Open-Lab-Instruments/LCR/hardware/LCR.kicad_pcb

## KiCad design 0_kicad_project/project/project.kicad_sch

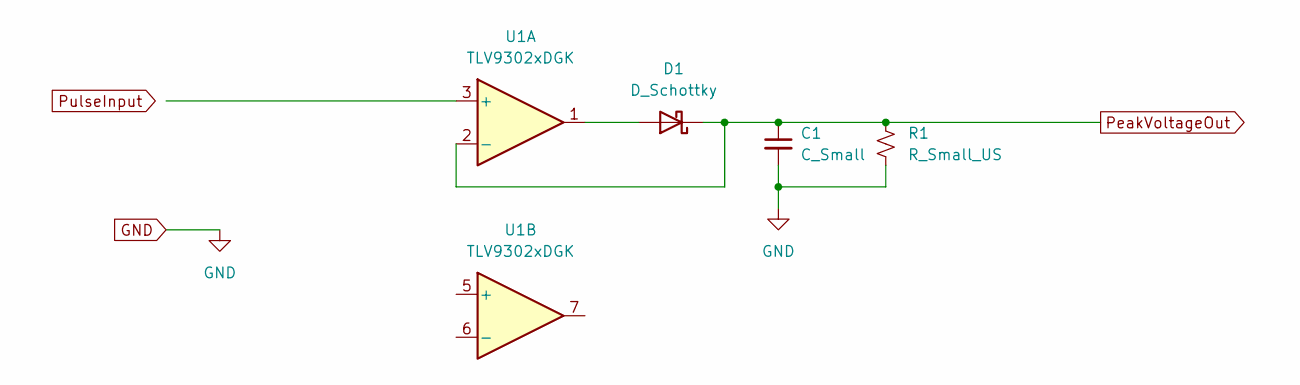
[picture p5: schematic project.kicad_sch]

Parts:
C1: C_Small
D1: D_Schottky
R1: R_Small_US
U1: TLV9302xDGK; MSOP-8_3x3mm_P0.65mm

Connections:
GND: C1.2, R1.2
unnamed: D1.2 (A), U1.1
PeakVoltageOut: C1.1, D1.1 (K), R1.1, U1.2 (-)
