Open-Lab-Instruments/LCR/software/LCRMeter/LCRMeter.ioc

Mcu.UserName=STM32F303VETx
PA0.GPIO_Label=TOUCH_IRQ
PA0.Signal=GPIO_Input
PA1.GPIO_Label=DISP_CS
PA1.Signal=GPIO_Output
PA10.Signal=USART1_RX
PA11.Signal=USB_DM
PA12.Signal=USB_DP
PA13.Signal=SYS_JTMS-SWDIO
PA14.Signal=SYS_JTCK-SWCLK
PA2.GPIO_Label=DISP_RST
PA2.Signal=GPIO_Output
PA3.GPIO_Label=SD_CS
PA3.Signal=GPIO_Output
PA5.Signal=SPI1_SCK
PA6.Signal=SPI1_MISO
PA7.Signal=SPI1_MOSI
PA8.GPIO_Label=USB_IDENT
PA8.Signal=GPIO_Output
PA9.Signal=USART1_TX
PB3.Signal=SPI3_SCK
PB4.Signal=SPI3_MISO
PB5.Signal=SPI3_MOSI
PB6.GPIO_Label=AD5941_CS
PB6.Signal=GPIO_Output
PB7.GPIO_Label=AD5941_RESET
PB7.Signal=GPIO_Output
PB8.GPIO_Label=SOUND_INT
PB8.Signal=S_TIM8_CH2
PC13.GPIO_Label=DISP_RS
PC13.Signal=GPIO_Output
PC14-OSC32_IN.GPIO_Label=DISP_WR
PC14-OSC32_IN.Signal=GPIO_Output
PC15-OSC32_OUT.GPIO_Label=DISP_RD
PC15-OSC32_OUT.Signal=GPIO_Output
PE0.GPIO_Label=DISP_IO0
PE0.Signal=GPIO_Output
PE1.GPIO_Label=DISP_IO1
PE1.Signal=GPIO_Output
PE10.GPIO_Label=DISP_IO10
PE10.Signal=GPIO_Output
PE11.GPIO_Label=DISP_IO11
PE11.Signal=GPIO_Output
PE12.GPIO_Label=DISP_IO12
PE12.Signal=GPIO_Output
PE13.GPIO_Label=DISP_IO13
PE13.Signal=GPIO_Output
PE14.GPIO_Label=DISP_IO14
PE14.Signal=GPIO_Output
PE15.GPIO_Label=DISP_IO15
PE15.Signal=GPIO_Output
PE2.GPIO_Label=DISP_IO2
PE2.Signal=GPIO_Output
PE3.GPIO_Label=DISP_IO3
PE3.Signal=GPIO_Output
PE4.GPIO_Label=DISP_IO4
PE4.Signal=GPIO_Output
PE5.GPIO_Label=DISP_IO5
PE5.Signal=GPIO_Output
PE6.GPIO_Label=DISP_IO6
PE6.Signal=GPIO_Output
PE7.GPIO_Label=DISP_IO7
PE7.Signal=GPIO_Output
PE8.GPIO_Label=DISP_IO8
PE8.Signal=GPIO_Output
PE9.GPIO_Label=DISP_IO9
PE9.Signal=GPIO_Output
PF0-OSC_IN.Signal=RCC_OSC_IN
PF1-OSC_OUT.Signal=RCC_OSC_OUT
PF9.GPIO_Label=TOUCH_CS
PF9.Signal=GPIO_Output
